andreacorbo/Buoy_Controller_v1/docs/source/software/boot.rst

####
Boot
####

The ``boot.py`` file contains code that runs once at boot time.

.. code-block:: python

    import pyb
    import uos

    pyb.freq(84000000)  # Sets main clock to reduce power consumption.

    pyb.usb_mode("VCP")  # Sets usb device to act only as virtual com port, needed
                         # to map pyboard to static dev on linux systems.

    try:
        uos.mount(pyb.SDCard(), "/sd")  # Mounts SD card to save data into.
    except:
        print("UNABLE TO MOUNT SD")
