andreacorbo/Buoy_Controller_v1/docs/source/software/device.rst

######
Device
######

The :mod:`device` module

.. autoclass:: device.DEVICE
    :members:
