andreacorbo/Buoy_Controller_v1/docs/source/software/devices/gps.rst

GPS - Global Position System
****************************

Standard GPS device:
====================
.. automodule:: dev_gps
  :members:
  :private-members:
  :member-order: bysource

Specific GPS devices:
=====================
.. toctree::
   :maxdepth: 1

   quectel
