andreacorbo/Buoy_Controller_v1/board/Buoy_Controller_v1.1_schematics.pdf

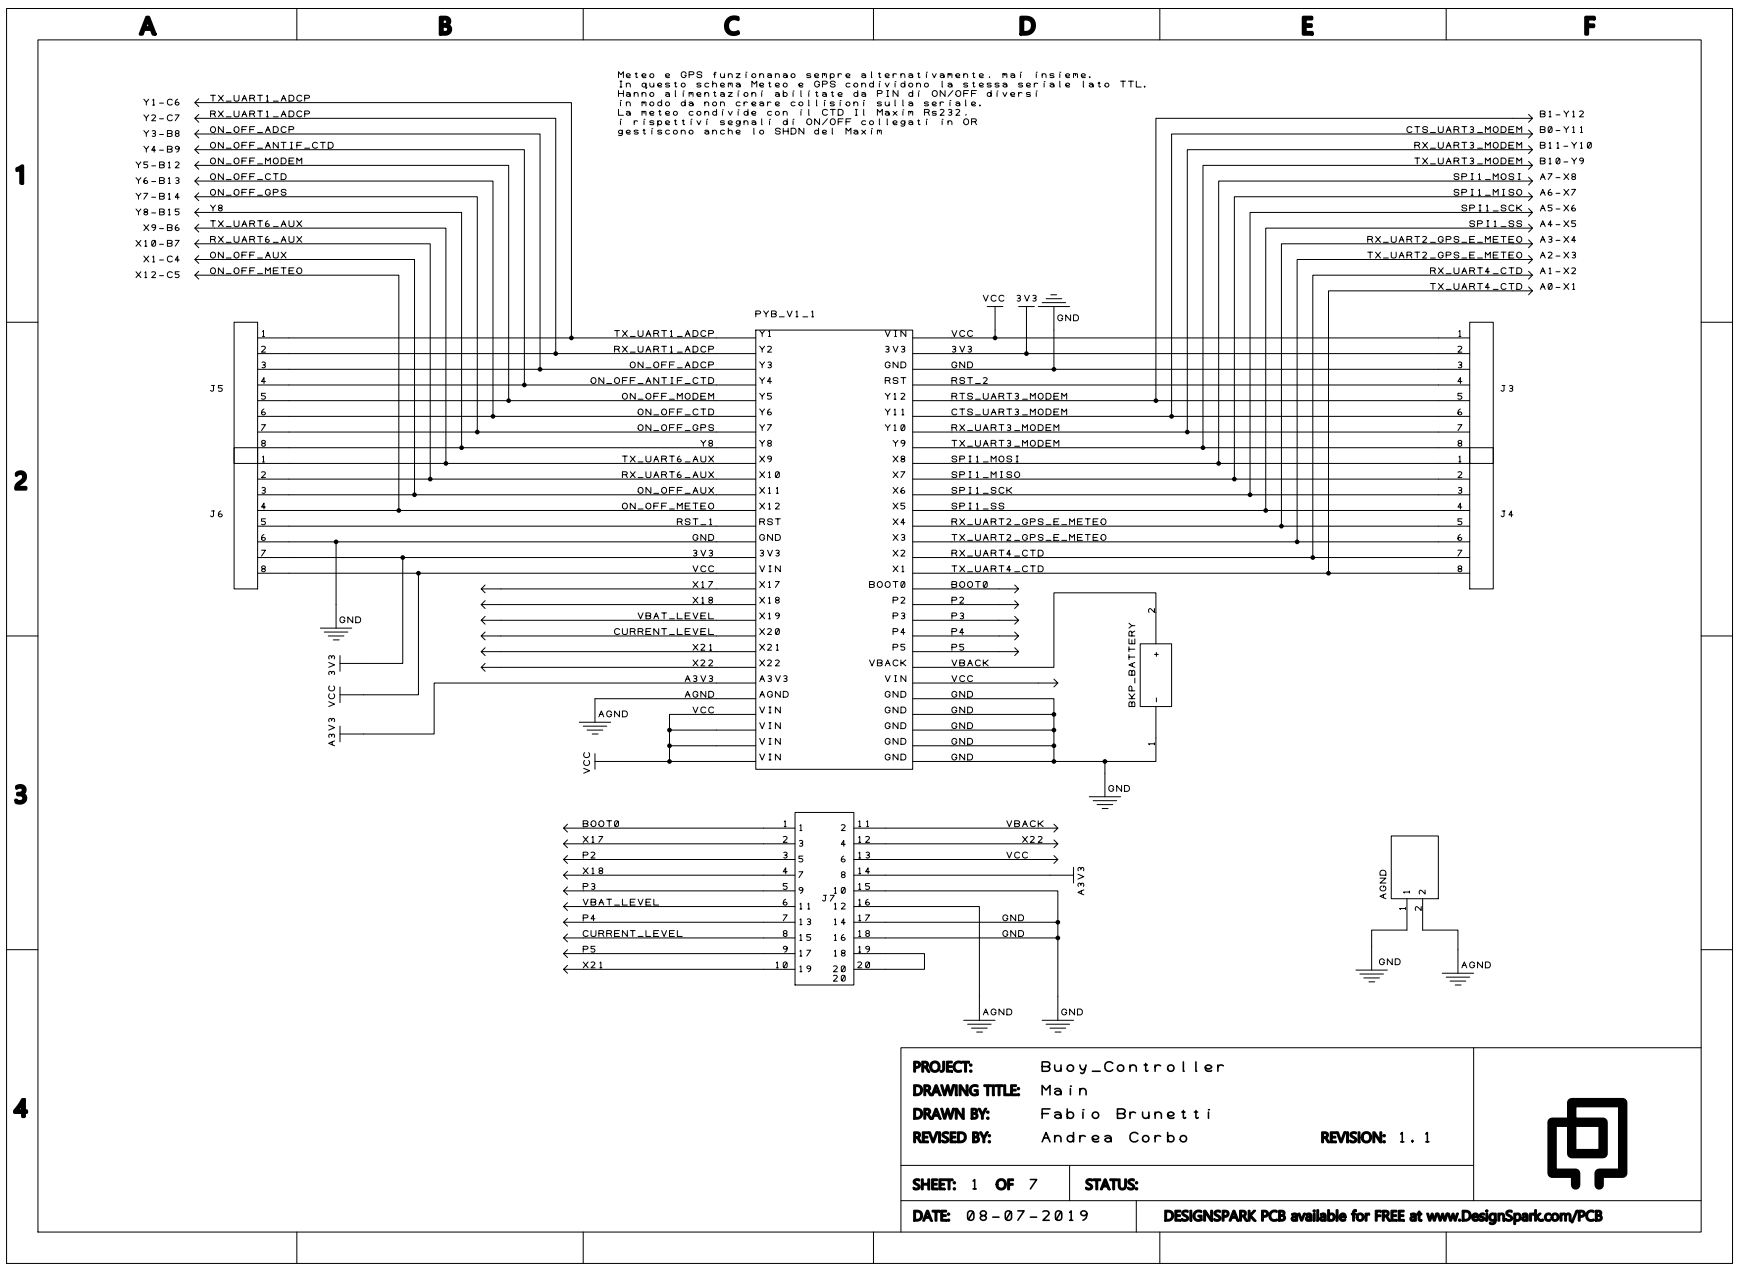
[picture p2: page 1]

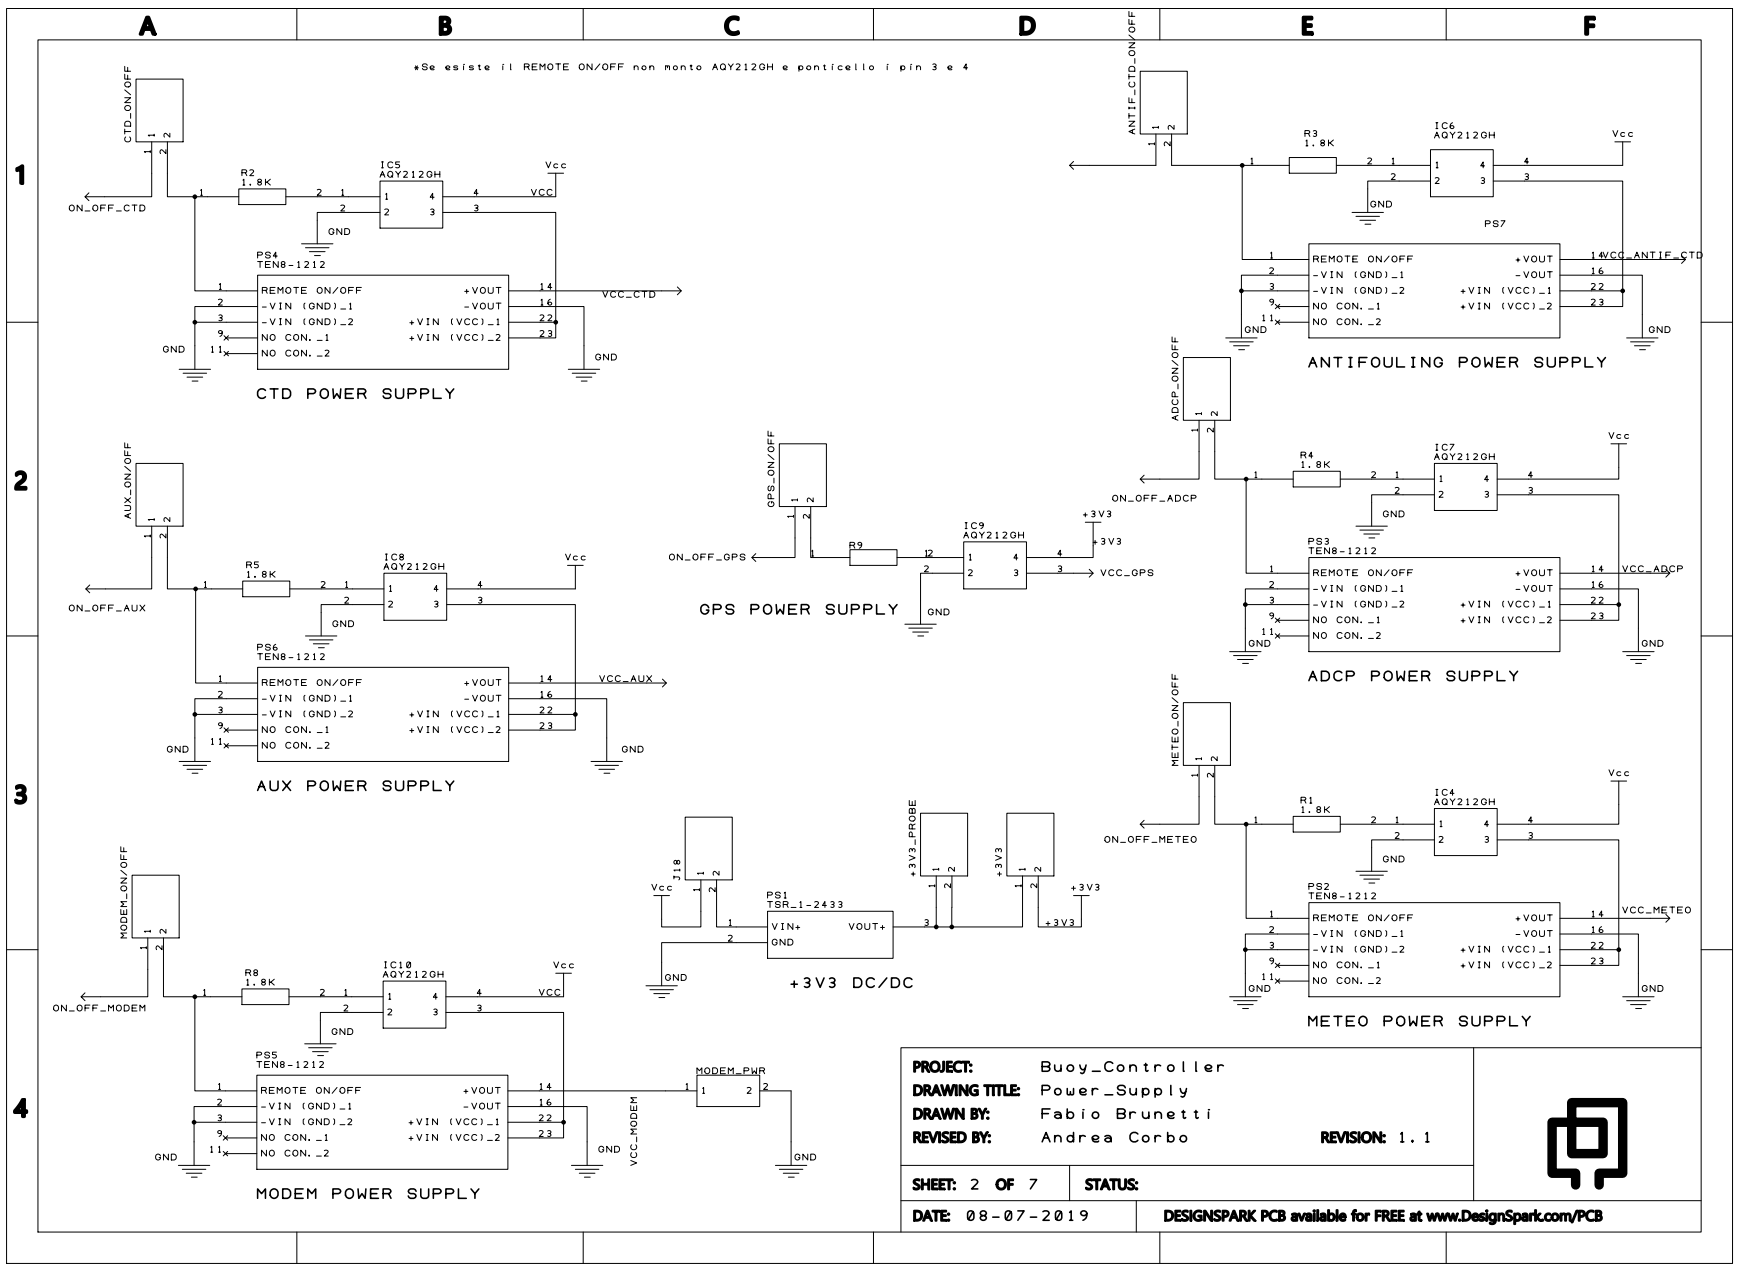
[picture p3: page 2]

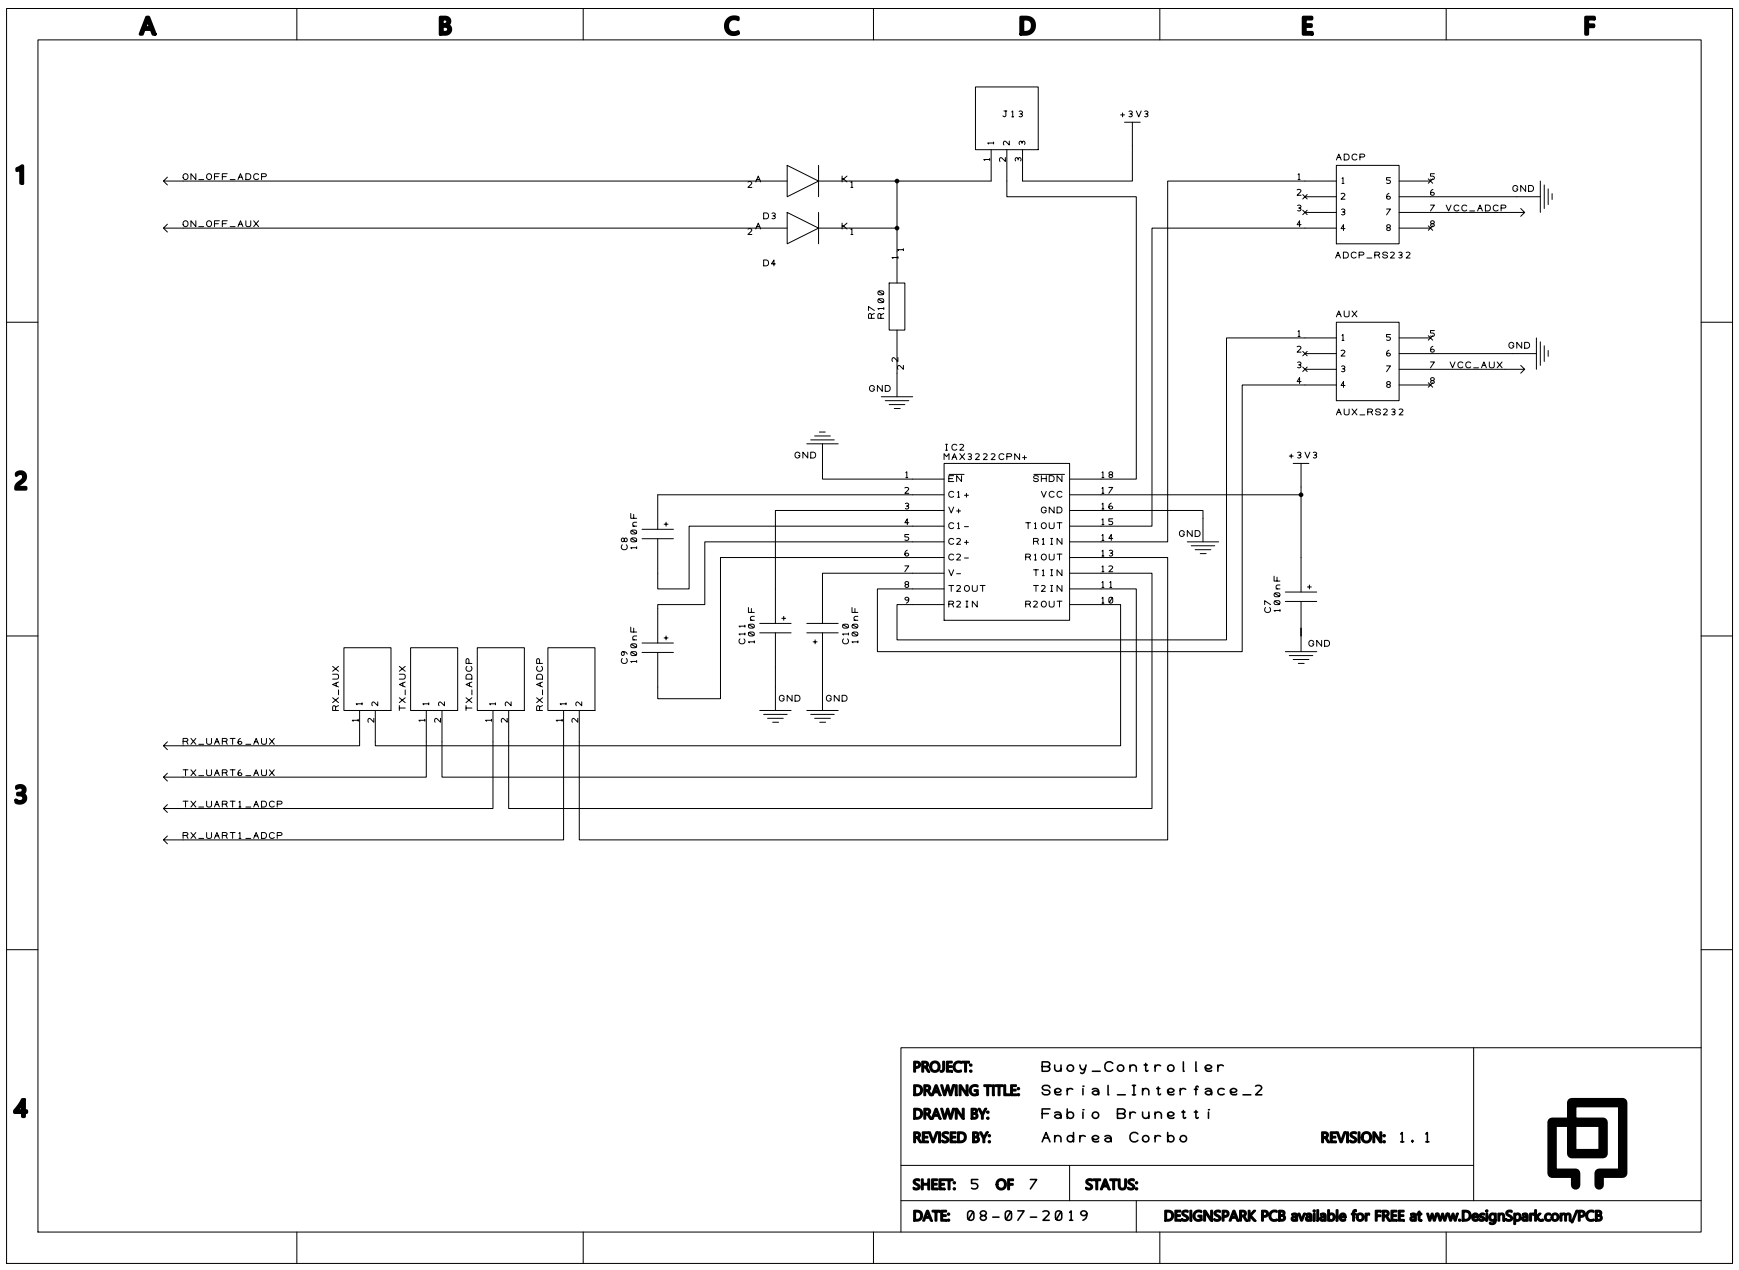
[picture p4: page 3]

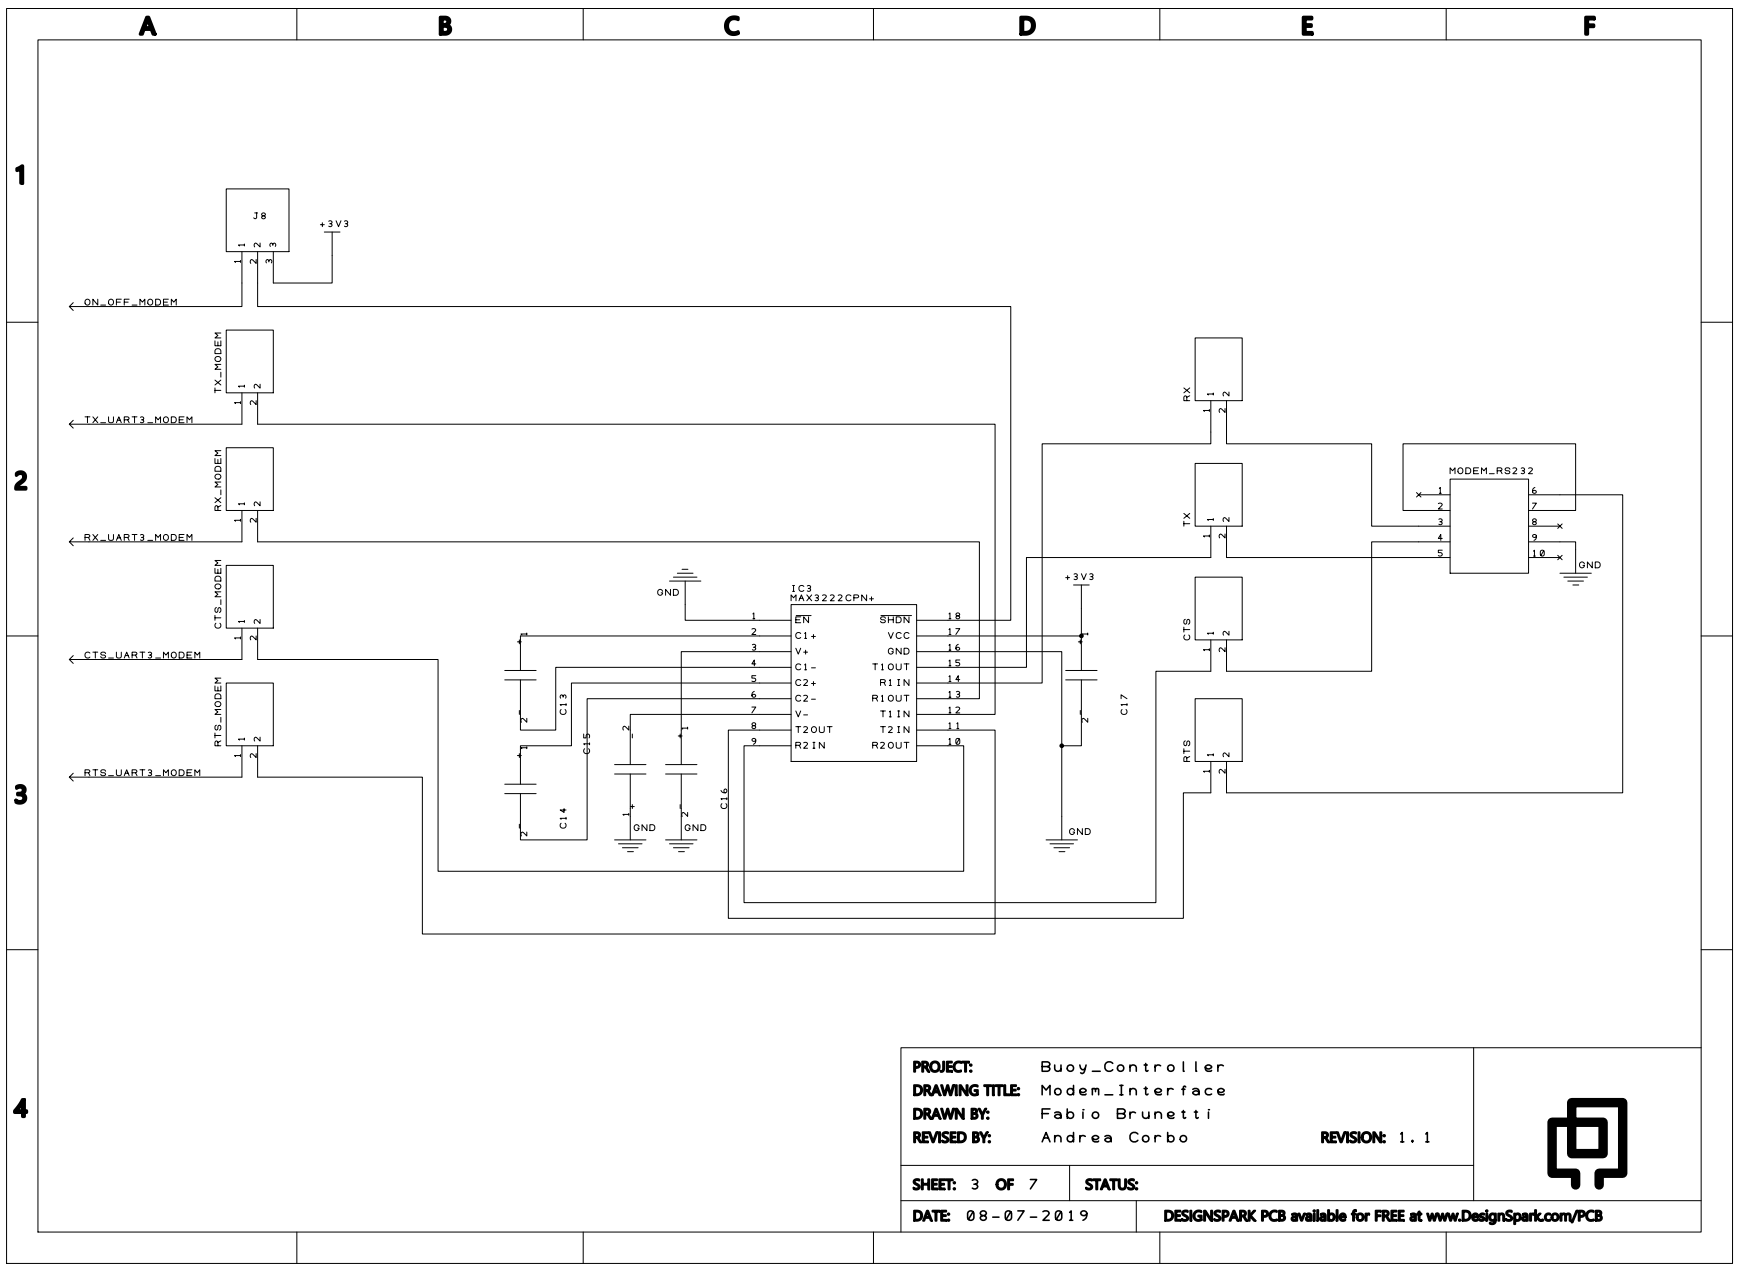
[picture p5: page 4]

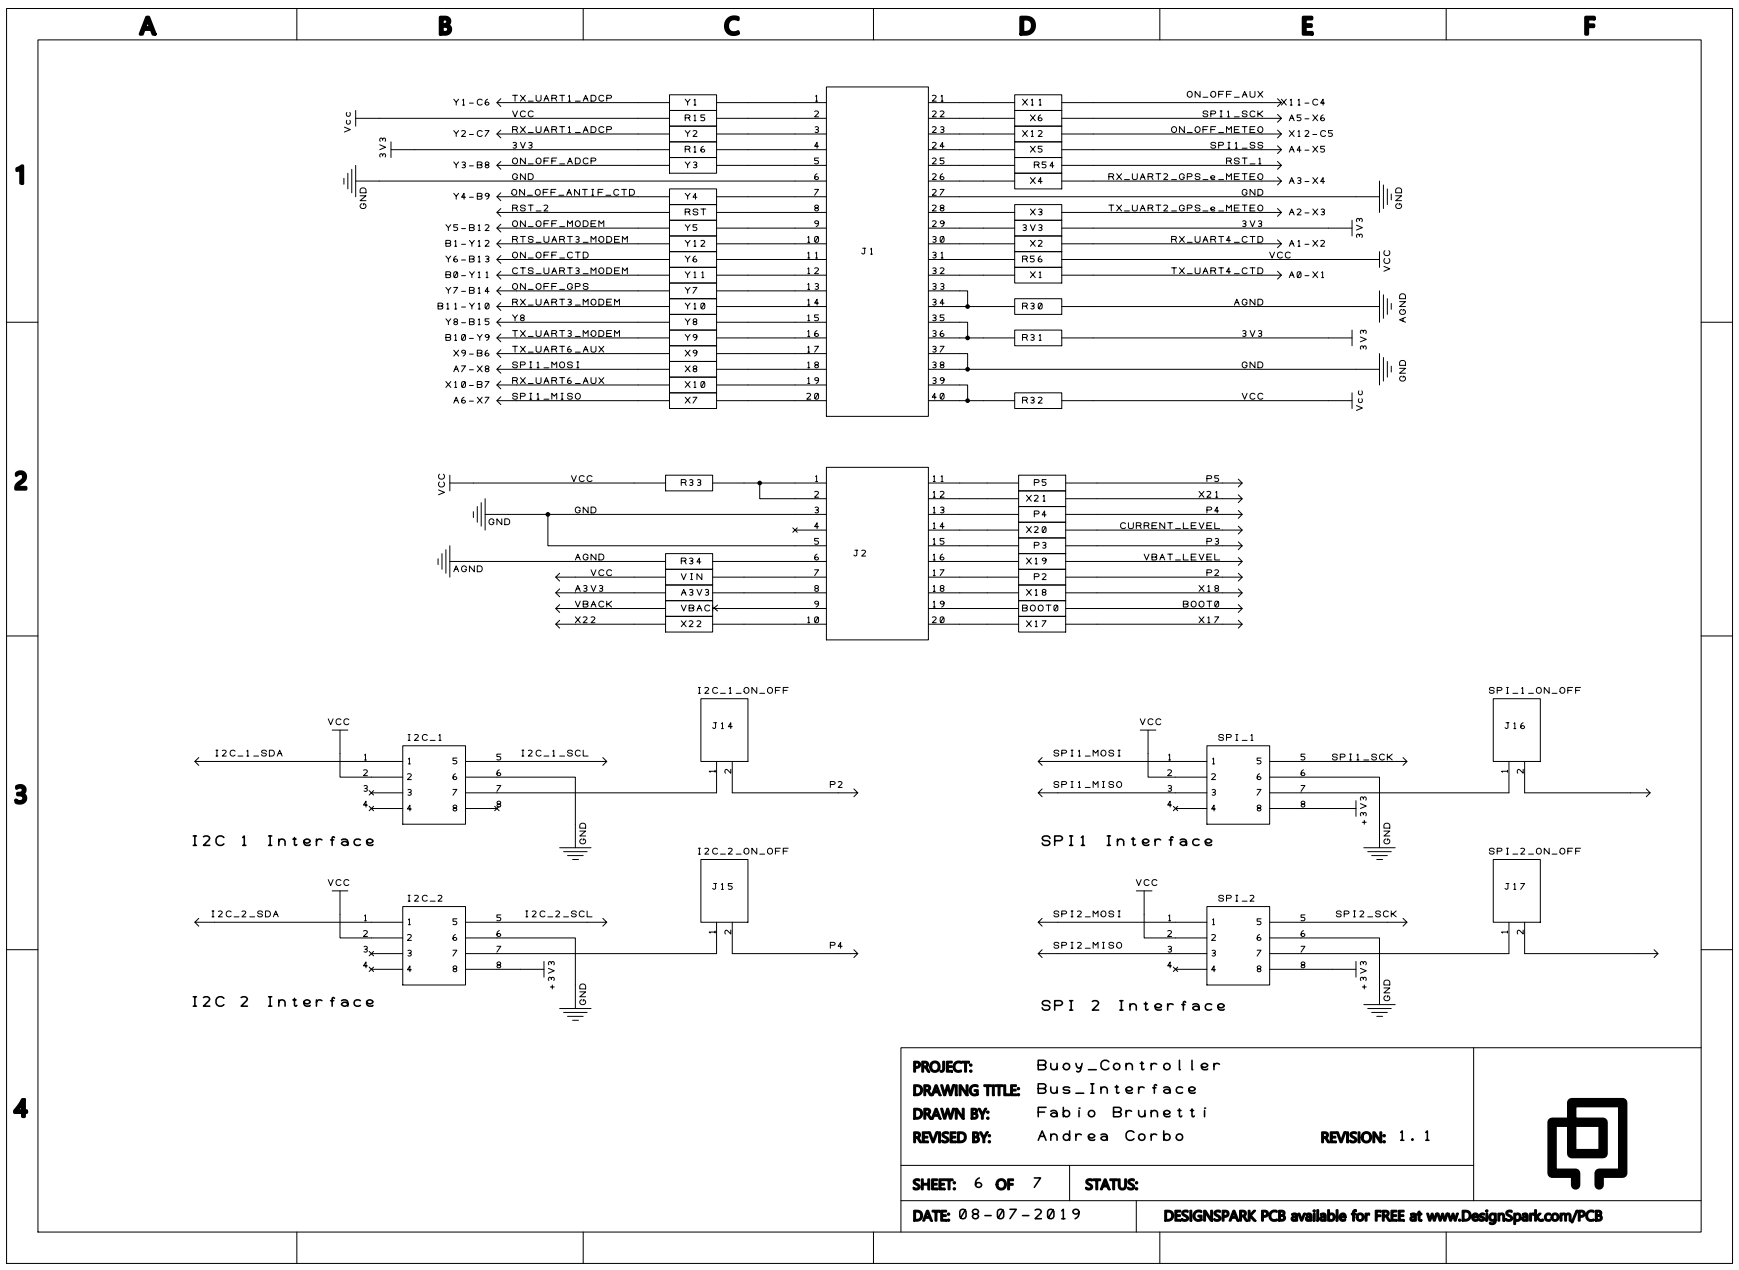
[picture p6: page 5]

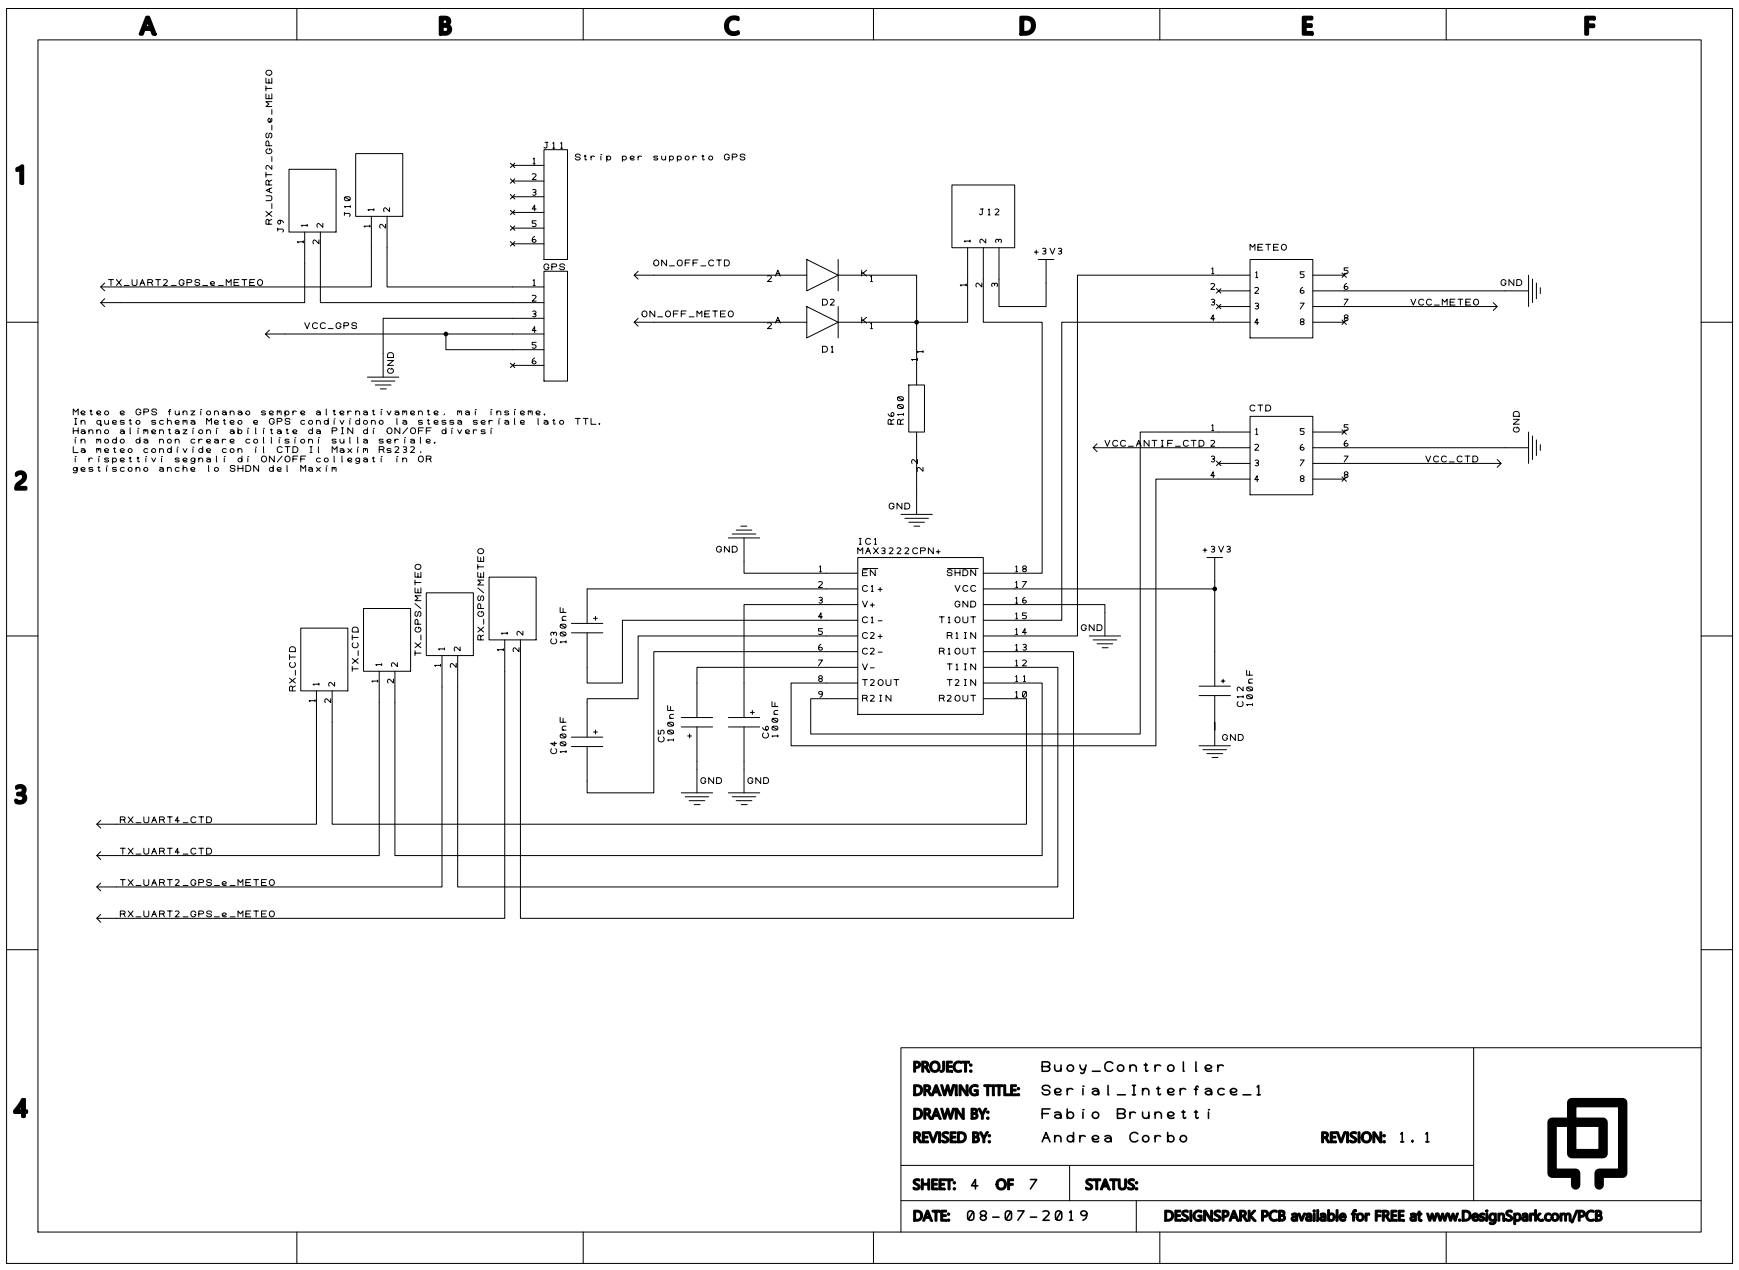
[picture p7: page 6]

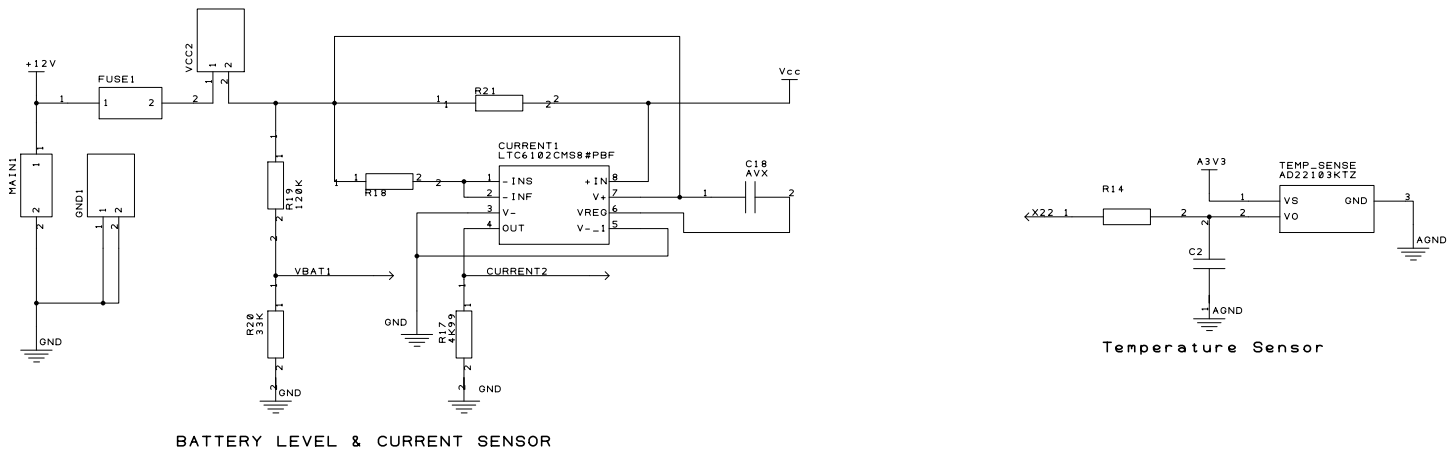
[picture p8: page 7]
