andreacorbo/Buoy_Controller_v1/(list of files, drawings)

Other design files:
board/Board.pcb
board/Logo.pcb
