andreacorbo/Buoy_Controller_v1/(commit log)

2020-04-05 v1.1 stable
    [Board (Bill Of Materials).csv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]
2020-05-20 added new documentation
    [config.rst.txt, configs.rst.txt, ~OnBoard_Sensing.sch]
